WojtaCZ/latte-hw/latte.kicad_pcb

## KiCad design latte.kicad_pcb (2023-11-26)

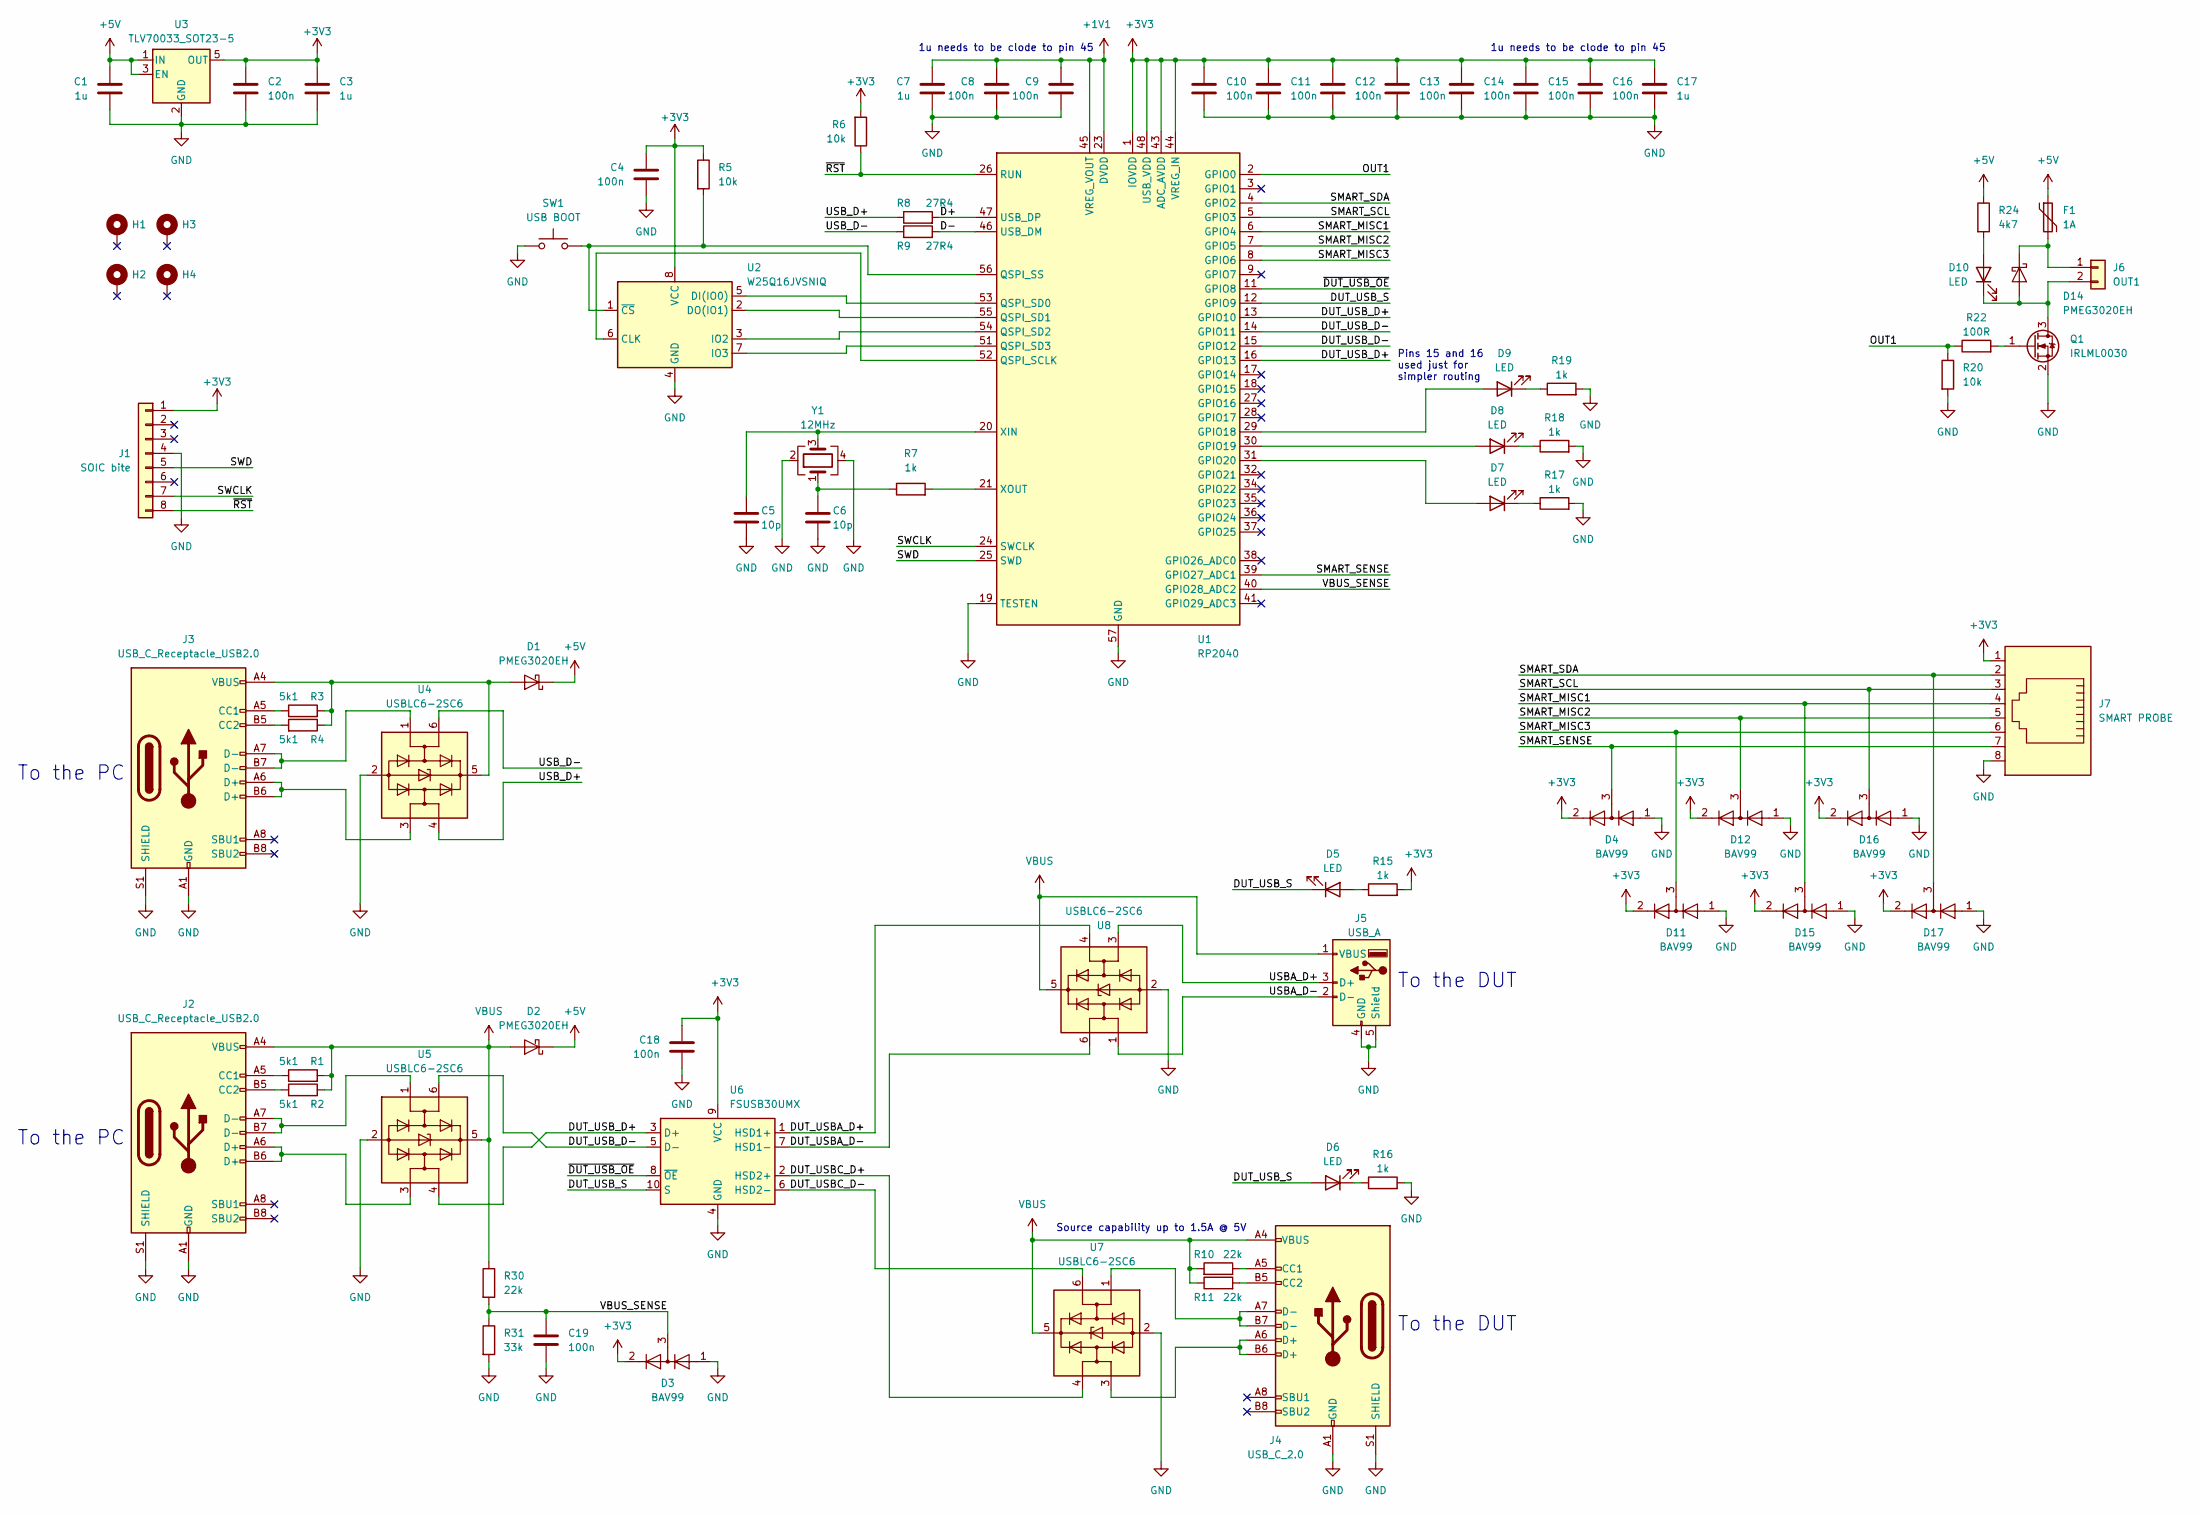
[picture p1: schematic latte.kicad_sch]

Parts:
C1, C3, C7, C17: 1u; C_0603_1608Metric
C2, C4, C8, C9, C10, C11, C12, C13, C14, C15, C16, C18, C19: 100n; C_0603_1608Metric
C5, C6: 10p; C_0603_1608Metric
D1, D2, D14: PMEG3020EH; D_SOD-123F
D3, D4, D11, D12, D15, D16, D17: BAV99; SOT-23
D5, D6, D7, D8, D9, D10: LED; LED_0603_1608Metric
F1: 1A; Fuse_0603_1608Metric
H1, H2, H3, H4: MountingHole_Pad; MountingHole_3.2mm_M3_Pad_Via
J1: SOIC bite; SOIC_clipProgSmall
J2, J3: USB_C_Receptacle_USB2.0; USB_C_Receptacle_XKB_U262-16XN-4BVC11
J4: USB_C_2.0; USB_C_Receptacle_XKB_U262-16XN-4BVC11
J5: USB_A; USB_A_Molex_67643_Horizontal
J6: OUT1; TerminalBlock_bornier-2_P5.08mm
J7: SMART PROBE; RJ45_Amphenol_54602-x08_Horizontal
Q1: IRLML0030; SOT-23
R1, R2, R3, R4: 5k1; R_0603_1608Metric
R5, R6, R20: 10k; R_0603_1608Metric
R7, R15, R16, R17, R18, R19: 1k; R_0603_1608Metric
R8, R9: 27R4; R_0603_1608Metric
R10, R11, R30: 22k; R_0603_1608Metric
R22: 100R; R_0603_1608Metric
R24: 4k7; R_0603_1608Metric
R31: 33k; R_0603_1608Metric
SW1: USB BOOT; SW_SPST_EVQPE1
U1: RP2040; QFN-56-1EP_7x7mm_P0.4mm_EP3.2x3.2mm
U2: W25Q16JVSNIQ; SOIC-8_3.9x4.9mm_P1.27mm
U3: TLV70033_SOT23-5; SOT-23-5
U4, U5, U7, U8: USBLC6-2SC6; SOT-23-6
U6: FSUSB30UMX; UQFN-10_1.3x1.8mm_P0.4mm
Y1: 12MHz; Crystal_SMD_3225-4Pin_3.2x2.5mm

Connections:
+1V1: C7.1, C8.1, C9.1, U1.23 (DVDD), U1.45 (VREG_VOUT), U1.50 (DVDD)
+3V3: C2.1, C3.1, C4.1, C10.1, C11.1, C12.1, C13.1, C14.1, C15.1, C16.1, C17.1, C18.1, D3.2 (A), D4.2 (A), D11.2 (A), D12.2 (A), D15.2 (A), D16.2 (A), D17.2 (A), J1.1, J7.1, R5.1, R6.2, R15.2, U1.1 (IOVDD), U1.10 (IOVDD), U1.22 (IOVDD), U1.33 (IOVDD), U1.42 (IOVDD), U1.43 (ADC_AVDD), U1.44 (VREG_IN), U1.48 (USB_VDD), U1.49 (IOVDD), U2.8 (VCC), U3.5 (OUT), U6.9 (VCC)
+5V: C1.2, D1.1 (K), D2.1 (K), F1.1, R24.1, U3.1 (IN), U3.3 (EN)
/D+: R8.2, U1.47 (USB_DP)
/D-: R9.2, U1.46 (USB_DM)
/DUT_USBA_D+: U6.1 (HSD1+), U8.4 (I/O2)
/DUT_USBA_D-: U6.7 (HSD1-), U8.6 (I/O1)
/DUT_USBC_D+: U6.2 (HSD2+), U7.4 (I/O2)
/DUT_USBC_D-: U6.6 (HSD2-), U7.6 (I/O1)
/DUT_USB_D+: U1.13 (GPIO10), U1.16 (GPIO13), U5.4 (I/O2), U6.3 (D+)
/DUT_USB_D-: U1.14 (GPIO11), U1.15 (GPIO12), U5.6 (I/O1), U6.5 (D-)
/DUT_USB_S: D5.1 (K), D6.2 (A), U1.12 (GPIO9), U6.10 (S)
/OUT1: R20.1, R22.1, U1.2 (GPIO0)
/SMART_MISC1: D15.3 (K), J7.4, U1.6 (GPIO4)
/SMART_MISC2: D12.3 (K), J7.5, U1.7 (GPIO5)
/SMART_MISC3: D11.3 (K), J7.6, U1.8 (GPIO6)
/SMART_SCL: D16.3 (K), J7.3, U1.5 (GPIO3)
/SMART_SDA: D17.3 (K), J7.2, U1.4 (GPIO2)
/SMART_SENSE: D4.3 (K), J7.7, U1.39 (GPIO27_ADC1)
/SWCLK: J1.7, U1.24 (SWCLK)
/SWD: J1.5, U1.25 (SWD)
/USBA_D+: J5.3 (D+), U8.3 (I/O2)
/USBA_D-: J5.2 (D-), U8.1 (I/O1)
/USB_D+: R8.1, U4.4 (I/O2)
/USB_D-: R9.1, U4.6 (I/O1)
/VBUS_SENSE: C19.1, D3.3 (K), R30.2, R31.1, U1.40 (GPIO28_ADC2)
/~DUT_USB_OE: U1.11 (GPIO8), U6.8 (~OE)
/~RST: J1.8, R6.1, U1.26 (RUN)
GND: C1.1, C2.2, C3.2, C4.2, C5.2, C6.2, C7.2, C8.2, C9.2, C10.2, C11.2, C12.2, C13.2, C14.2, C15.2, C16.2, C17.2, C18.2, C19.2, D3.1 (K), D4.1 (K), D11.1 (K), D12.1 (K), D15.1 (K), D16.1 (K), D17.1 (K), J1.4, J2.A1 (GND), J2.A12 (GND), J2.B1 (GND), J2.B12 (GND), J2.S1 (SHIELD), J3.A1 (GND), J3.A12 (GND), J3.B1 (GND), J3.B12 (GND), J3.S1 (SHIELD), J4.A1 (GND), J4.A12 (GND), J4.B1 (GND), J4.B12 (GND), J4.S1 (SHIELD), J5.4 (GND), J5.5 (Shield), J7.8, Q1.2 (S), R16.2, R17.2, R18.2, R19.2, R20.2, R31.2, SW1.1, U1.19 (TESTEN), U1.57 (GND), U2.4 (GND), U3.2 (GND), U4.2 (GND), U5.2 (GND), U6.4 (GND), U7.2 (GND), U8.2 (GND), Y1.2, Y1.4
unnamed: C5.1, U1.20 (XIN), Y1.3
unnamed: C6.1, R7.1, Y1.1
unnamed: D1.2 (A), J3.A4 (VBUS), J3.A9 (VBUS), J3.B4 (VBUS), J3.B9 (VBUS), R3.2, R4.1, U4.5 (VBUS)
unnamed: D5.2 (A), R15.1
unnamed: D6.1 (K), R16.1
unnamed: D7.1 (K), R17.1
unnamed: D7.2 (A), U1.31 (GPIO20)
unnamed: D8.1 (K), R18.1
unnamed: D8.2 (A), U1.30 (GPIO19)
unnamed: D9.1 (K), R19.1
unnamed: D9.2 (A), U1.29 (GPIO18)
unnamed: D10.1 (K), D14.2 (A), J6.2, Q1.3 (D)
unnamed: D10.2 (A), R24.2
unnamed: D14.1 (K), F1.2, J6.1
unnamed: J2.A5 (CC1), R1.1
unnamed: J2.A6 (D+), J2.B6 (D+), U5.3 (I/O2)
unnamed: J2.A7 (D-), J2.B7 (D-), U5.1 (I/O1)
unnamed: J2.B5 (CC2), R2.2
unnamed: J3.A5 (CC1), R3.1
unnamed: J3.A6 (D+), J3.B6 (D+), U4.3 (I/O2)
unnamed: J3.A7 (D-), J3.B7 (D-), U4.1 (I/O1)
unnamed: J3.B5 (CC2), R4.2
unnamed: J4.A5 (CC1), R10.1
unnamed: J4.A6 (D+), J4.B6 (D+), U7.3 (I/O2)
unnamed: J4.A7 (D-), J4.B7 (D-), U7.1 (I/O1)
unnamed: J4.B5 (CC2), R11.2
unnamed: Q1.1 (G), R22.2
unnamed: R5.2, SW1.2, U1.56 (QSPI_SS), U2.1 (~CS)
unnamed: R7.2, U1.21 (XOUT)
unnamed: U1.51 (QSPI_SD3), U2.7 (IO3)
unnamed: U1.52 (QSPI_SCLK), U2.6 (CLK)
unnamed: U1.53 (QSPI_SD0), U2.5 (DI(IO0))
unnamed: U1.54 (QSPI_SD2), U2.3 (IO2)
unnamed: U1.55 (QSPI_SD1), U2.2 (DO(IO1))
VBUS: D2.2 (A), J2.A4 (VBUS), J2.A9 (VBUS), J2.B4 (VBUS), J2.B9 (VBUS), J4.A4 (VBUS), J4.A9 (VBUS), J4.B4 (VBUS), J4.B9 (VBUS), J5.1 (VBUS), R1.2, R2.1, R10.2, R11.1, R30.1, U5.5 (VBUS), U7.5 (VBUS), U8.5 (VBUS)

Notes on the sheet:
1u needs to be clode to pin 45
To the PC
Pins 15 and 16 used just for simpler routing
Source capability up to 1.5A @ 5V
To the DUT

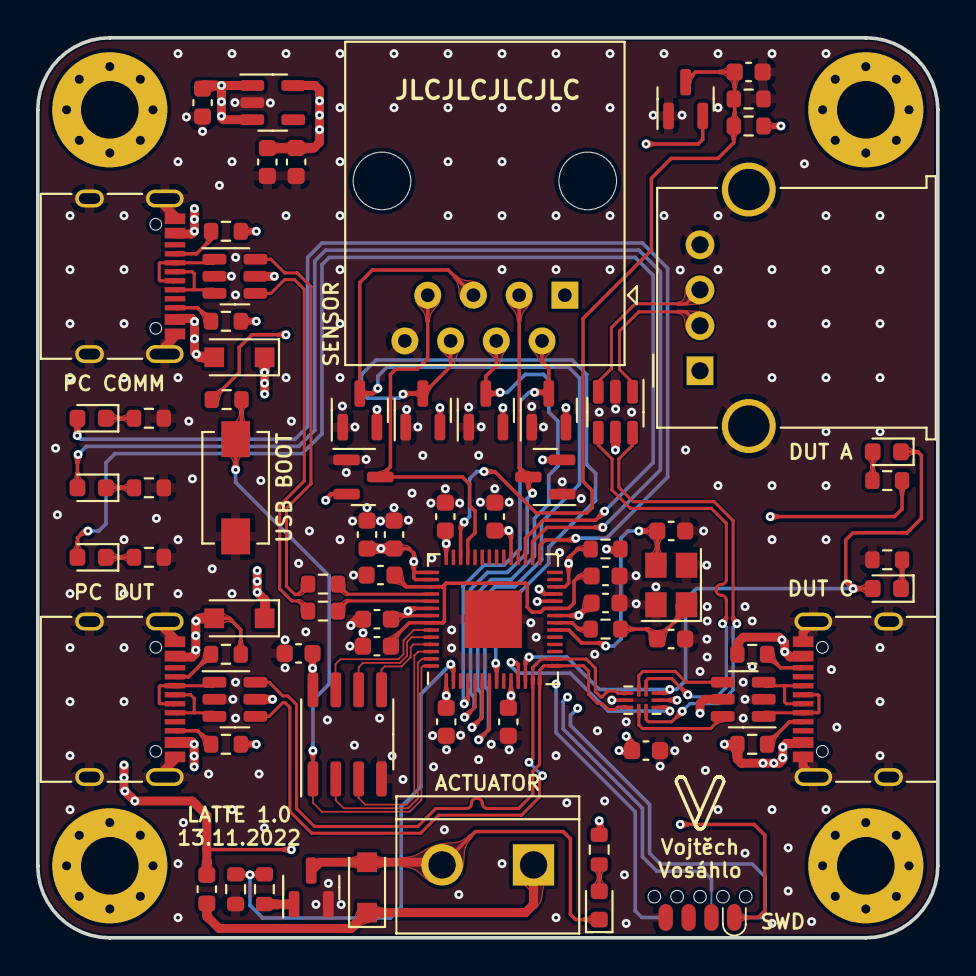
[picture p2: board latte.kicad_pcb from above]

Board: 4 copper layers, 50.0 x 50.0 mm, 79 parts (0 on the bottom side), 64 nets.
