WojtaCZ/latte-hw/(commit log)

2022-11-07 Schematic done
    [latte.kicad_pcb, latte.kicad_sch]
2022-11-07 Rough layout done
    [latte.kicad_pcb, latte.kicad_sch]
2022-11-08 Fixed project structure
    [latte.kicad_pcb, latte.kicad_sch]
2022-11-08 Diff pair routing done
    [latte.kicad_pcb, latte.kicad_sch]
2022-11-13 Routing done
    [latte.kicad_pcb, latte.kicad_sch]
2022-11-13 Added via stitching
    [latte.kicad_pcb]
2022-11-18 Added logo
    [latte-B_Cu.gbl, latte-B_Mask.gbs, latte-B_Paste.gbp, latte-B_Silkscreen.gbo, latte-Edge_Cuts.gm1, latte-F_Cu.gtl, latte-F_Mask.gts, latte-F_Paste.gtp]
2022-11-24 Finalized for production
    [latte-B_Cu.gbl, latte-B_Mask.gbs, latte-B_Paste.gbp, latte-B_Silkscreen.gbo, latte-Edge_Cuts.gm1, latte-F_Cu.gtl, latte-F_Mask.gts, latte-F_Paste.gtp]
2023-03-11 Fixed switched D+/D- on PC DUT USB connector
    [latte.kicad_sch]
